jnedbal/MicroFLiC_servo_solenoid_bottom_1_1/MicroFLiC_servo_solenoid_bottom.csv

Reference | Quantity | Value | Footprint | Datasheet | Part Number | Manufacturer | Package | Supplier | Order Code | Alt. Supplier | Alt. Order Code | Note
C1 | 1 | 100p | Capacitors_SMD:C_0805 |  | CGA4C2C0G2A101J060AA | TDK | 0805 | Farnell | 2210931 | Mouser | 810-CGA4C2C0G2A101J | 100pF/100V C0G(NP0) 0805 ceramic capacitor
C2 C3 | 2 | 10n | Capacitors_SMD:C_0805 |  | MCU0805R103KCT | Multicomp | 0805 | Farnell | 9406352 | Mouser | 710-885012207092 | 10nF/50V X7R 0805 ceramic capacitor
C4 C5 C6 C7 | 4 | 4u7/25V | Capacitors_SMD:C_0805 |  | GRM21BR61E475MA12L | Murata | 0805 | Farnell | 2362111 | Mouser | 81-GRM21BR61E475MA2L | 4.7μF/25V X5R 0805 ceramic capacitor
C8 C9 | 2 | 100n | Capacitors_SMD:C_0805 |  | MC0805B104K250CT | Multicomp | 0805 | Farnell | 1759166 | Mouser | 710-885012207098 | 100nF/50V X7R 0805 ceramic capacitor
D1 D2 | 2 | LED RED | LEDs:LED-1206 |  | HSMS-C150 | Broadcom | 1206 | Farnell | 2497366 | Mouser | 630-HSMS-C150 | Red 1206 LED
D3 D5 | 2 | LED YELLOW | LEDs:LED-1206 |  | HSMY-C150 | Broadcom | 1206 | Farnell | 2497382 | Mouser | 630-HSMY-C150 | Yellow 1206 LED
D4 D6 D7 D8 | 4 | 1N4148 | jakub:SOD-323 |  | 1N4148WS | Multicomp | SOD-323 | Farnell | 1466524 | Mouser | 512-1N4148WS | Optional small signal SOD-323 diode
P1 | 1 | 1x14 header strip | Pin_Headers:Pin_Header_Straight_1x14 |  | MC34735 | Multicomp | SIL-14 | Farnell | 1593421 | Mouser | 855-M20-9991446 | 1x14 header strip
P10 | 1 | 1x4 socket strip | jakub:ESQ-104-33-G-S |  | ESQ-104-33-G-S | Samtec | SIL-4 | Farnell | 1928522 | Samtec | ESQ-104-33-G-S | 1x4 ESQ series elevated socket strip
P11 P12 | 2 | 2x3 header strip R/A | Pin_Headers:Pin_Header_Angled_2x03 |  | 2213R-06G | Multicomp | DIL-6 | Farnell | 1593449 | Mouser | 517-9612065604AR | 2x3 right-angle header strip
P2 | 1 | 1x14 socket strip | jakub:ESQ-114-33-G-S |  | ESQ-114-33-G-S | Samtec | SIL-14 | Farnell | 1930609 | Samtec | ESQ-114-33-G-S | 1x14 ESQ series elevated socket strip
P3 | 1 | 12-way Micro-MaTch | jakub:1-188275-2 |  | 8-188275-2 | TE Connectivity | Micro-MaTch SMD | Farnell | 3784757 | Mouser | 571-8-188275-2 | 12-way SMD Micro-MaTch connector
P4 P5 | 2 | 3.5mm jack | jakub:MJ4435-R |  | MJ4435-R | Multicomp | R/A 3.5mm jack | Farnell | 1638670 | N/A | N/A | Right-angle SMD 3.5mm 3-pin jack
P6 P7 | 2 | RCA jack | jakub:PSG01544 |  | PSG01540 | Pro Signal | R/A RCA jack | Farnell | 1280698 | N/A | N/A | Right-angle RCA jack
P8 | 1 | 1x6 socket strip | jakub:ESQ-106-33-G-S |  | ESQ-106-33-G-S | Samtec | SIL-6 | Farnell | 1928680 | Samtec | ESQ-106-33-G-S | 1x6 ESQ series elevated socket strip
P9 | 1 | 1x4 header strip | Pin_Headers:Pin_Header_Straight_1x04 |  | M20-9990445 | Harwin | SIL-4 | Farnell | 1926221 | Mouser | 855-M20-9990445 | 1x4 header strip
R1 R4 R5 | 3 | 270k | Resistors_SMD:R_0805 |  | MCSR08X2703FTL | Multicomp | 0805 | Farnell | 2074426 | Mouser | ERJ-6ENF2703V | 270kΩ/1% 0805 resistor
R2 R3 | 2 | 1k5 | Resistors_SMD:R_0805 |  | MCWR08X1501FTL | Multicomp | 0805 | Farnell | 2447592 | Mouser | 71-CRCW0805-1.5K-E3 | 1.5kΩ/1% 0805 resistor
R6 R7 | 2 | 10k | Resistors_SMD:R_0805 |  | MCMR08X1002FTL | Multicomp | 0805 | Farnell | 2073607 | Mouser | 71-CRCW0805-10K-E3 | 10kΩ/1% 0805 resistor
R8 R9 | 2 | 3k | Resistors_SMD:R_0805 |  | MC01W080513K | Multicomp | 0805 | Farnell | 9332995 | Mouser | 667-ERJ-6GEYJ302V | 3kΩ/1% 0805 resistor
U1 | 1 | PCA9306DP | Housings_SSOP:TSSOP-8_3x3mm_Pitch0.65mm |  | PCA9306DP | NXP Semiconductors | TSSOP-8 | Farnell | 2212072 | Mouser | 771-PCA9306DP-T | Dual I²C-bus voltage translator
U2 U3 | 2 | DRV103 | Housings_SOIC:SOIC-8_3.9x4.9mm_Pitch1.27mm |  | DRV103UG4 | Texas Instruments | SOIC-8 | Farnell | 1206892 | Mouser | 595-DRV103UG4 | PWM low-side driver for solenoids
U4 | 1 | 74HCT1G125 | TO_SOT_Packages_SMD:SOT-23-5 |  | SN74AHCT1G126DBVR | Texas Instruments | SOT23-5 | Farnell | 2342371 | Mouser | 595-SNAHCT1G126DBVR | Single bus buffer gate with 3-state output
U5 | 1 | MCP4728 | Housings_SSOP:MSOP-10_3x3mm_Pitch0.5mm |  | MCP4728-E/UN | Microchip | MSOP-10 | Farnell | 1800217 | Mouser | 579-MCP4728-E/UN | 12-bit quad digital-to-analog converter with EEPROM memory
