jnedbal/MicroFLiC_servo_solenoid_bottom_1_1/MicroFLiC_servo_solenoid_bottom.kicad_pcb

## KiCad design MicroFLiC_servo_solenoid_bottom.kicad_pcb (2016-03-18)

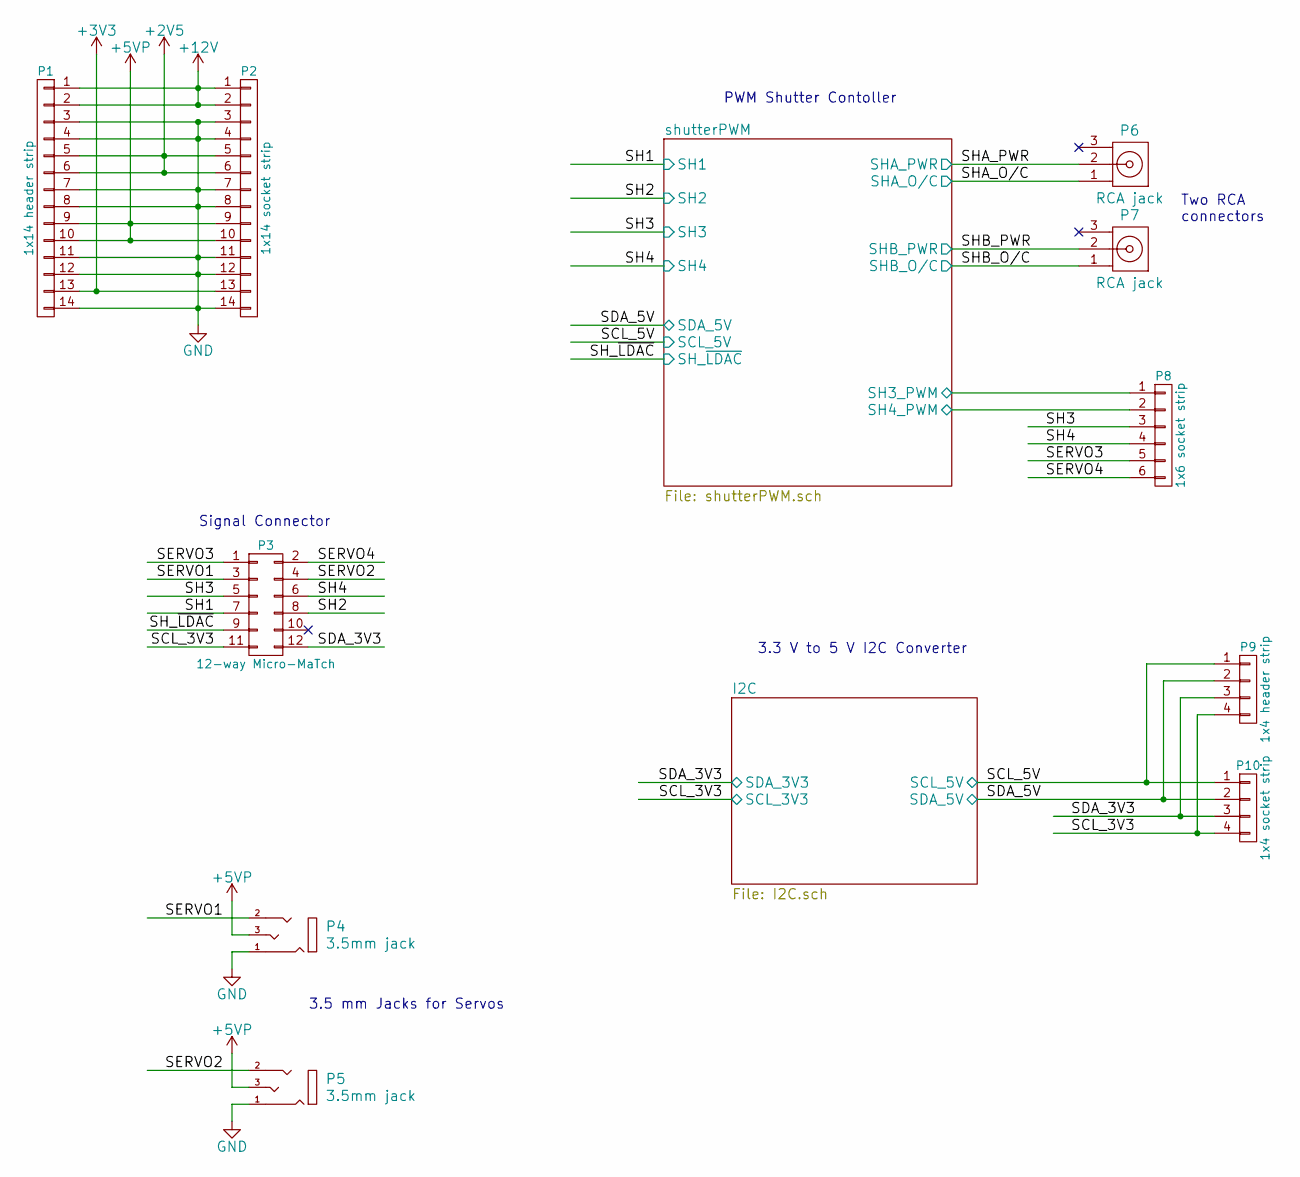
[picture p1: schematic MicroFLiC_servo_solenoid_bottom.sch, Flow Unit Shield]

Parts:
P1: 1x14 header strip; Pin_Header_Straight_1x14; Part Number MC34735
P2: 1x14 socket strip; ESQ-114-33-G-S; Part Number ESQ-114-33-G-S
P3: 12-way Micro-MaTch; 1-188275-2; Part Number 8-188275-2
P4, P5: 3.5mm jack; MJ4435-R; Part Number MJ4435-R
P6, P7: RCA jack; PSG01544; Part Number PSG01540
P8: 1x6 socket strip; ESQ-106-33-G-S; Part Number ESQ-106-33-G-S
P9: 1x4 header strip; Pin_Header_Straight_1x04; Part Number M20-9990445
P10: 1x4 socket strip; ESQ-104-33-G-S; Part Number ESQ-104-33-G-S

Connections:
+2V5: P1.5, P1.6, P2.5, P2.6; also elsewhere on the board
+3V3: P1.13, P2.13; also elsewhere on the board
+5VP: P1.9, P1.10, P2.9, P2.10, P4.3, P5.3; also elsewhere on the board
+12V: P1.1, P1.2, P2.1, P2.2; also elsewhere on the board
/I2C/SCL_3V3: P3.11, P9.4, P10.4; also elsewhere on the board
/I2C/SCL_5V: P9.1, P10.1; also elsewhere on the board
/I2C/SDA_3V3: P3.12, P9.3, P10.3; also elsewhere on the board
/I2C/SDA_5V: P9.2, P10.2; also elsewhere on the board
/SERVO1: P3.3, P4.2
/SERVO2: P3.4, P5.2
/SERVO3: P3.1, P8.5
/SERVO4: P3.2, P8.6
/SH3: P3.5, P8.3
/SH4: P3.6, P8.4
/shutterPWM/SH1: P3.7; also elsewhere on the board
/shutterPWM/SH2: P3.8; also elsewhere on the board
/shutterPWM/SH3_PWM: P8.1; also elsewhere on the board
/shutterPWM/SH4_PWM: P8.2; also elsewhere on the board
/shutterPWM/SHA_O/C: P6.1; also elsewhere on the board
/shutterPWM/SHA_PWR: P6.2; also elsewhere on the board
/shutterPWM/SHB_O/C: P7.1; also elsewhere on the board
/shutterPWM/SHB_PWR: P7.2; also elsewhere on the board
/shutterPWM/SH_~LDAC: P3.9; also elsewhere on the board
GND: P1.3, P1.4, P1.7, P1.8, P1.11, P1.12, P1.14, P2.3, P2.4, P2.7, P2.8, P2.11, P2.12, P2.14, P4.1, P5.1; also elsewhere on the board

Notes on the sheet:
Two RCA connectors
3.3 V to 5 V I2C Converter
PWM Shutter Contoller
Signal Connector
3.5 mm Jacks for Servos

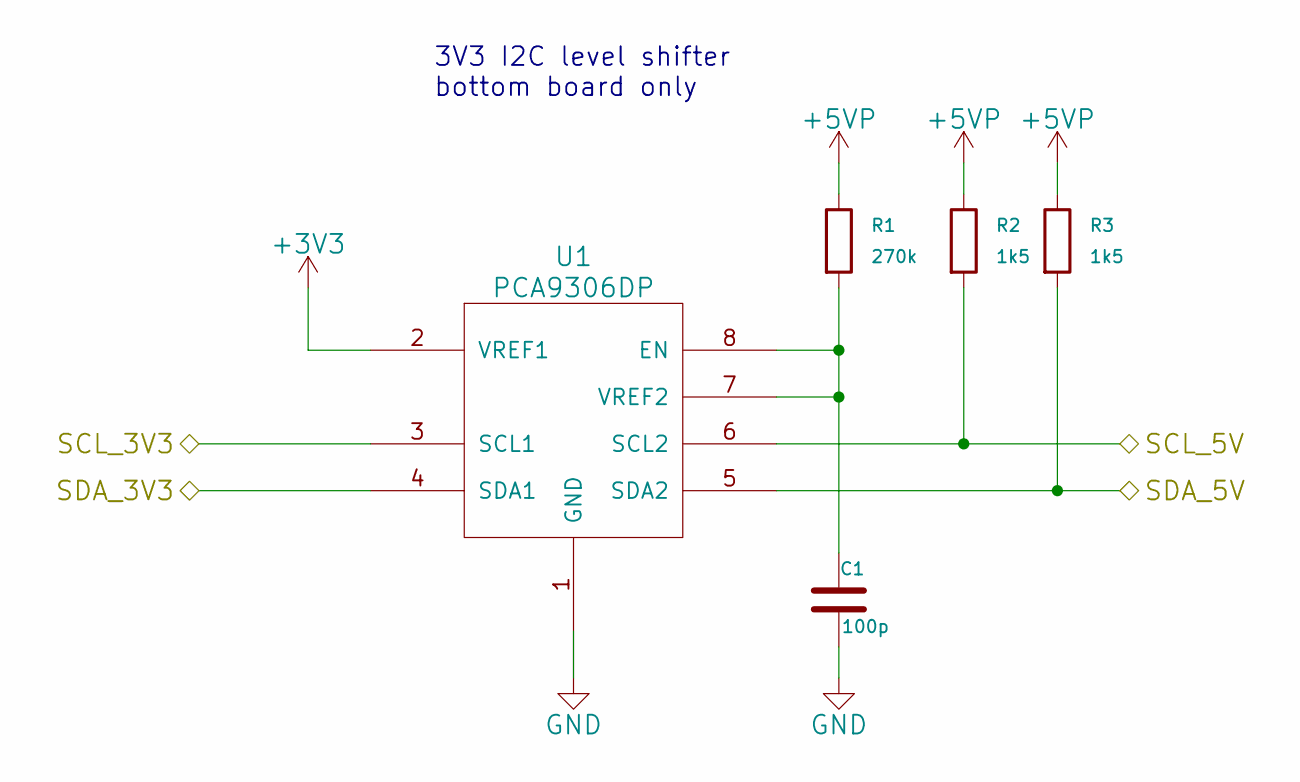
[picture p2: schematic I2C.sch, Flow Unit Shield]

Parts:
C1: 100p; C_0805; Part Number CGA4C2C0G2A101J060AA
R1: 270k; R_0805; Part Number MCSR08X2703FTL
R2, R3: 1k5; R_0805; Part Number MCWR08X1501FTL
U1: PCA9306DP; TSSOP-8_3x3mm_Pitch0.65mm; Part Number PCA9306DP

Connections:
+3V3: U1.2 (VREF1); also elsewhere on the board
+5VP: R1.1, R2.1, R3.1; also elsewhere on the board
/I2C/SCL_3V3: U1.3 (SCL1); also elsewhere on the board
/I2C/SCL_5V: R2.2, U1.6 (SCL2); also elsewhere on the board
/I2C/SDA_3V3: U1.4 (SDA1); also elsewhere on the board
/I2C/SDA_5V: R3.2, U1.5 (SDA2); also elsewhere on the board
GND: C1.2, U1.1 (GND); also elsewhere on the board
unnamed: C1.1, R1.2, U1.7 (VREF2), U1.8 (EN)

Notes on the sheet:
3V3 I2C level shifter bottom board only

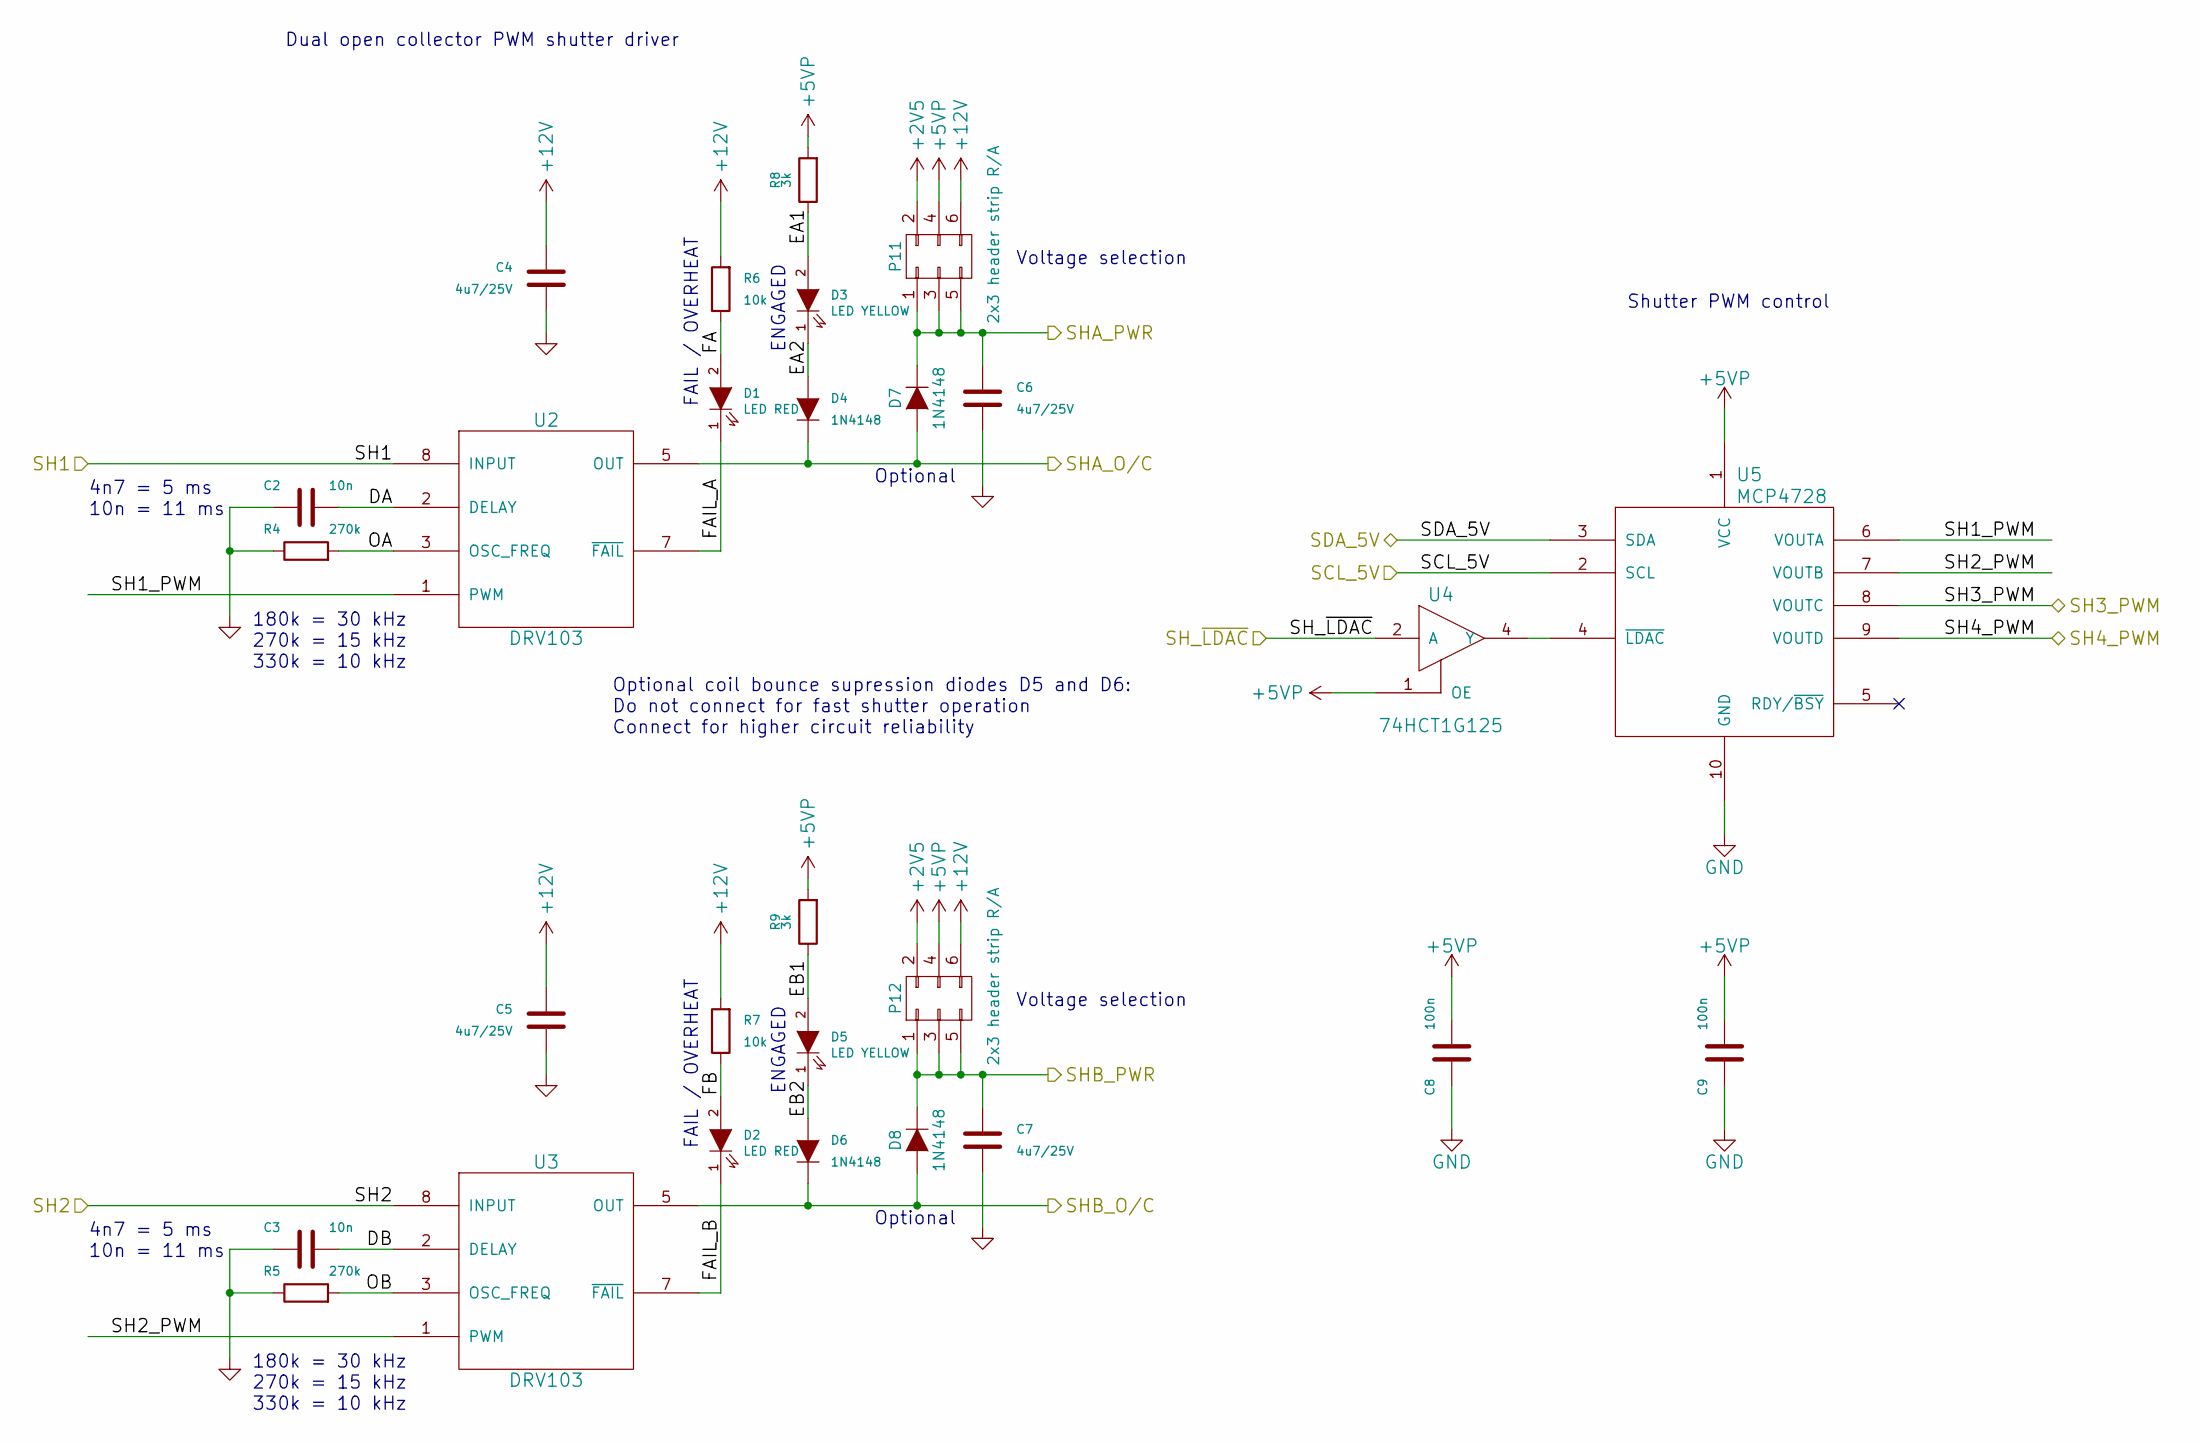
[picture p3: schematic shutterPWM.sch, Flow Unit Shield]

Parts:
C2, C3: 10n; C_0805; Part Number MCU0805R103KCT
C4, C5, C6, C7: 4u7/25V; C_0805; Part Number GRM21BR61E475MA12L
C8, C9: 100n; C_0805; Part Number MC0805B104K250CT
D1, D2: LED RED; LED-1206; Part Number HSMS-C150
D3, D5: LED YELLOW; LED-1206; Part Number HSMY-C150
D4, D6, D7, D8: 1N4148; SOD-323; Part Number 1N4148WS
P11, P12: 2x3 header strip R/A; Pin_Header_Angled_2x03; Part Number 2213R-06G
R4, R5: 270k; R_0805; Part Number MCSR08X2703FTL
R6, R7: 10k; R_0805; Part Number MCMR08X1002FTL
R8, R9: 3k; R_0805; Part Number MC01W080513K
U2, U3: DRV103; SOIC-8_3.9x4.9mm_Pitch1.27mm; Part Number DRV103UG4
U4: 74HCT1G125; SOT-23-5; Part Number SN74AHCT1G126DBVR
U5: MCP4728; MSOP-10_3x3mm_Pitch0.5mm; Part Number MCP4728-E/UN

Connections:
+2V5: P11.2, P12.2; also elsewhere on the board
+5VP: C8.2, C9.2, P11.4, P12.4, R8.2, R9.2, U4.1 (OE), U4.5 (+5VP), U5.1 (VCC); also elsewhere on the board
+12V: C4.2, C5.2, P11.6, P12.6, R6.2, R7.2, U2.6 (+12V), U3.6 (+12V); also elsewhere on the board
/I2C/SCL_5V: U5.2 (SCL); also elsewhere on the board
/I2C/SDA_5V: U5.3 (SDA); also elsewhere on the board
/shutterPWM/DA: C2.2, U2.2 (DELAY)
/shutterPWM/DB: C3.2, U3.2 (DELAY)
/shutterPWM/EA1: D3.2 (A), R8.1
/shutterPWM/EA2: D3.1 (K), D4.2 (A)
/shutterPWM/EB1: D5.2 (A), R9.1
/shutterPWM/EB2: D5.1 (K), D6.2 (A)
/shutterPWM/FA: D1.2 (A), R6.1
/shutterPWM/FAIL_A: D1.1 (K), U2.7 (~FAIL)
/shutterPWM/FAIL_B: D2.1 (K), U3.7 (~FAIL)
/shutterPWM/FB: D2.2 (A), R7.1
/shutterPWM/OA: R4.2, U2.3 (OSC_FREQ)
/shutterPWM/OB: R5.2, U3.3 (OSC_FREQ)
/shutterPWM/SH1: U2.8 (INPUT); also elsewhere on the board
/shutterPWM/SH1_PWM: U2.1 (PWM), U5.6 (VOUTA)
/shutterPWM/SH2: U3.8 (INPUT); also elsewhere on the board
/shutterPWM/SH2_PWM: U3.1 (PWM), U5.7 (VOUTB)
/shutterPWM/SH3_PWM: U5.8 (VOUTC); also elsewhere on the board
/shutterPWM/SH4_PWM: U5.9 (VOUTD); also elsewhere on the board
/shutterPWM/SHA_O/C: D4.1 (K), D7.2 (A), U2.5 (OUT); also elsewhere on the board
/shutterPWM/SHA_PWR: C6.2, D7.1 (K), P11.1, P11.3, P11.5; also elsewhere on the board
/shutterPWM/SHB_O/C: D6.1 (K), D8.2 (A), U3.5 (OUT); also elsewhere on the board
/shutterPWM/SHB_PWR: C7.2, D8.1 (K), P12.1, P12.3, P12.5; also elsewhere on the board
/shutterPWM/SH_~LDAC: U4.2 (A); also elsewhere on the board
GND: C2.1, C3.1, C4.1, C5.1, C6.1, C7.1, C8.1, C9.1, R4.1, R5.1, U2.4 (GND), U3.4 (GND), U4.3 (GND), U5.10 (GND); also elsewhere on the board
unnamed: U4.4 (Y), U5.4 (~LDAC)

Notes on the sheet:
Dual open collector PWM shutter driver
Optional coil bounce supression diodes D5 and D6: Do not connect for fast shutter operation Connect for higher circuit reliability
180k = 30 kHz 270k = 15 kHz 330k = 10 kHz
4n7 = 5 ms 10n = 11 ms
Shutter PWM control
FAIL / OVERHEAT
ENGAGED
Optional
Voltage selection

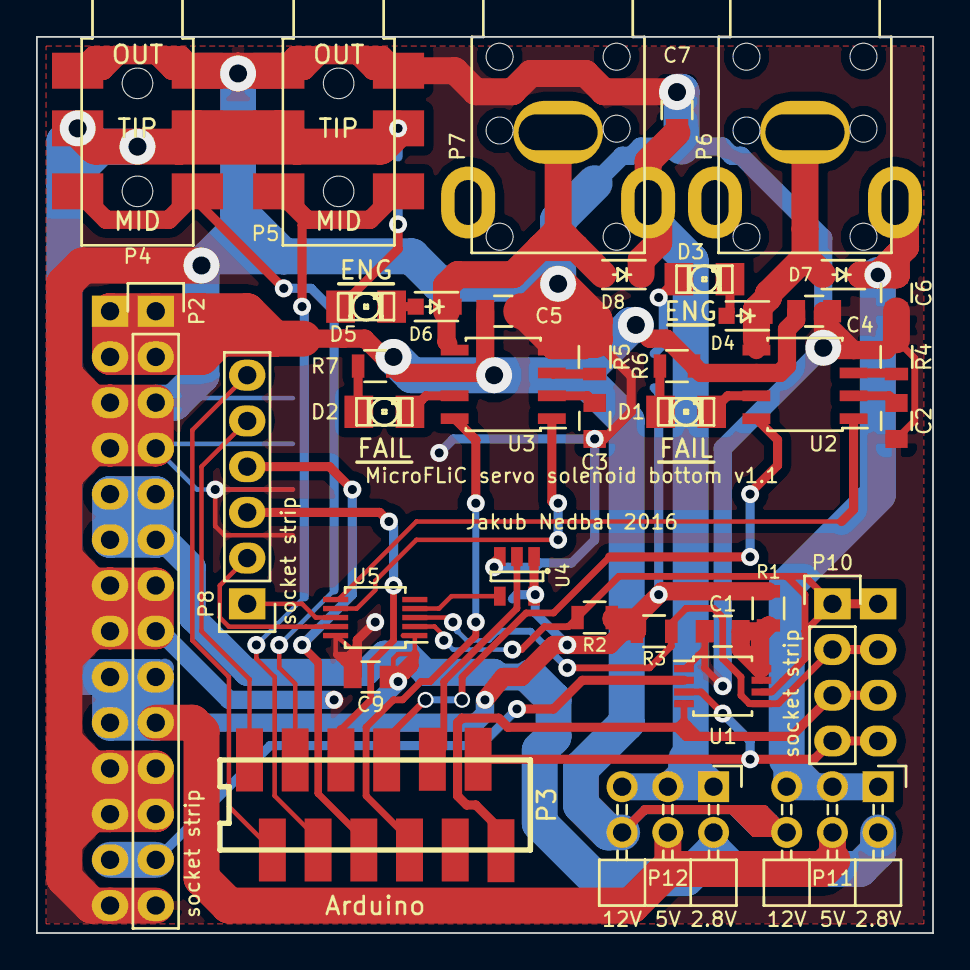
[picture p4: board MicroFLiC_servo_solenoid_bottom.kicad_pcb from above]

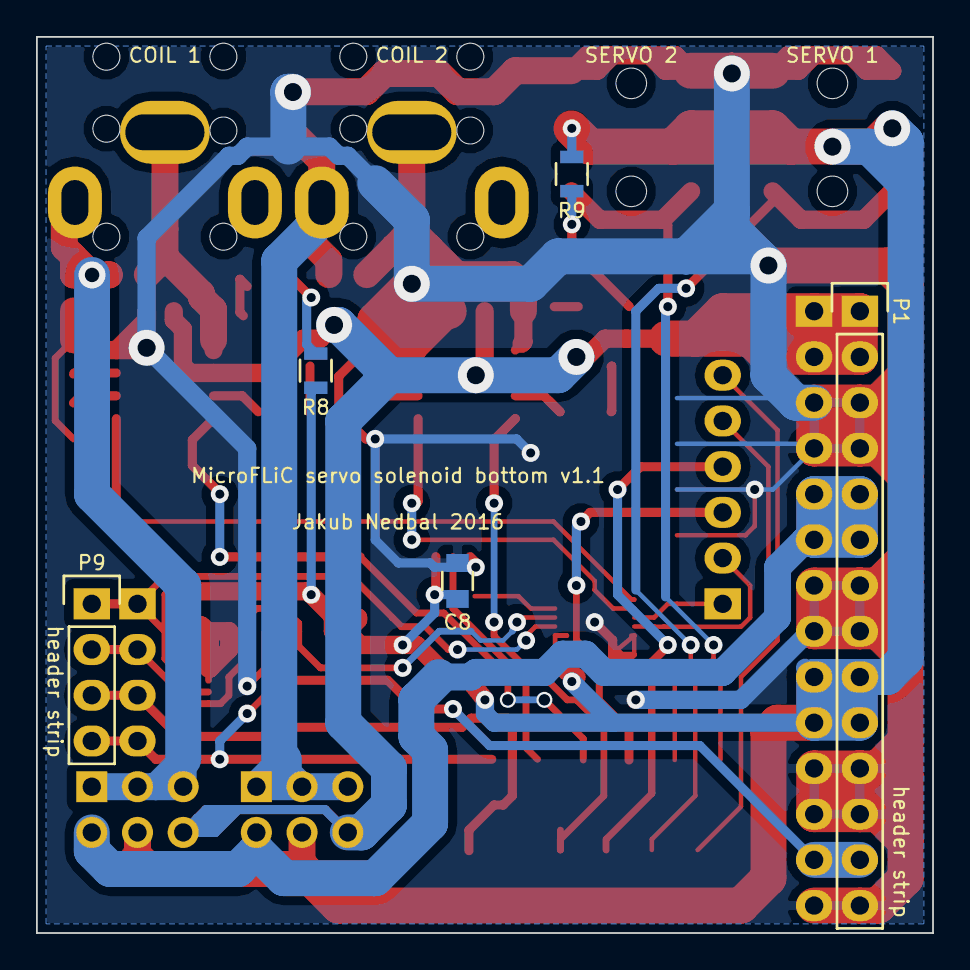
[picture p5: board MicroFLiC_servo_solenoid_bottom.kicad_pcb from below]

Board: 2 copper layers, 49.8 x 49.8 mm, 43 parts (5 on the bottom side), 40 nets.
