jnedbal/MicroFLiC_servo_solenoid_bottom_1_1/(commit log)

2016-02-29 Added board name, created new Gerber plots
    [MicroFLiC_servo_solenoid_bottom-B.Cu.gbl, MicroFLiC_servo_solenoid_bottom-B.Mask.gbs, MicroFLiC_servo_solenoid_bottom-B.SilkS.gbo, MicroFLiC_servo_solenoid_bottom-Edge.Cuts.gm1, MicroFLiC_servo_solenoid_bottom-F.Cu.gtl, MicroFLiC_servo_solenoid_bottom-F.Mask.gts, MicroFLiC_servo_solenoid_bottom-F.SilkS.gto, MicroFLiC_servo_solenoid_bottom.drl]
2016-03-02 Fixed jack part values
    [MicroFLiC_servo_solenoid_bottom.csv, MicroFLiC_servo_solenoid_bottom.kicad_pcb, MicroFLiC_servo_solenoid_bottom.sch]
2016-03-02 Added better de-bouncing diode description
    [MicroFLiC_servo_solenoid_bottom.csv, shutterPWM.sch]
2016-03-18 Added pullup resistors to I2C
    [I2C.sch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]
2016-03-18 Changed ENGAGED LED anode to +5V, changed SOD-323 packages.
    [I2C.sch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]
2016-03-18 Changed 100n->100p capacitor on the I2C level shifter
    [I2C.sch, MicroFLiC_servo_solenoid_bottom.csv, MicroFLiC_servo_solenoid_bottom.kicad_pcb]
